seanboe/fsr_controller/scripts/images/insole.png

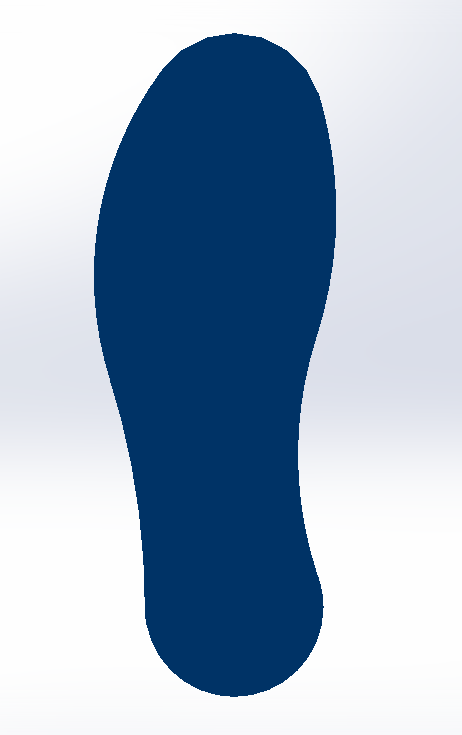
scripts/images/insole.png
