seanboe/fsr_controller/v2/footprint/QFN50P300X300X90-17N.step

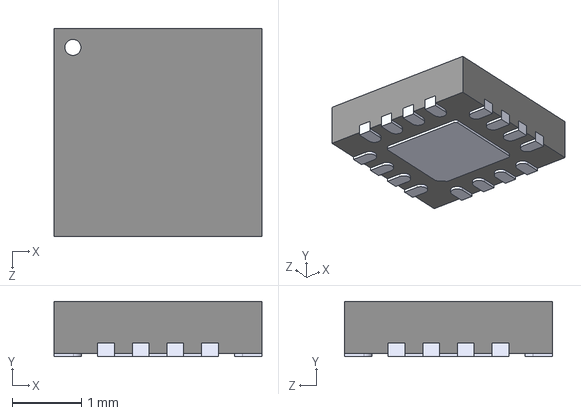
[picture p2: CAD file, 2024-06-18]
v2/footprint/QFN50P300X300X90-17N.step
3.00 x 0.8 x 3.00 mm
