seanboe/fsr_controller/v2/fsr_controller.step

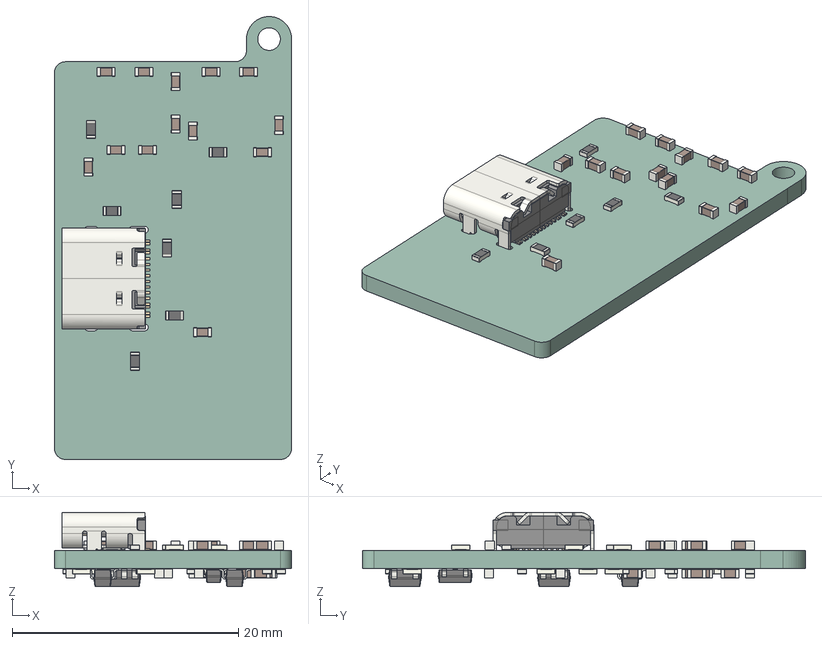
[picture p3: CAD file, 2025-02-23]
v2/fsr_controller.step
21.0 x 39.2 x 6.56 mm
C_0603_1608Metric x 26
R_0603_1608Metric x 23
USB_C_Receptacle_16P_TopMnt_Horizontal_GCT_USB4105-xx-A
SOT_23_5 x 3
SOT_23
fsr_controller2_PCB
