seanboe/fsr_controller/v2/Motor Bracket2.stl

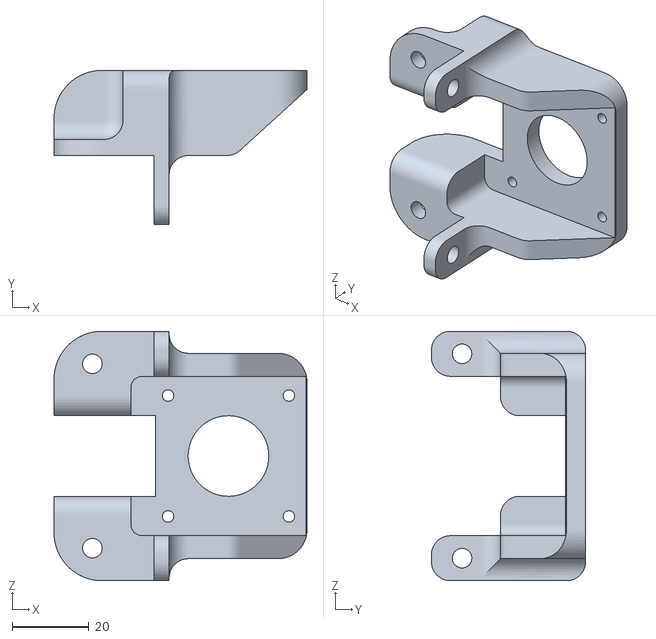
[picture p5: CAD file, 2024-06-18]
v2/Motor Bracket2.stl
65.9 x 40.2 x 65.0
