seanboe/fsr_controller/v2/footprint/ATWINC1500-MR210PB STEP model.STEP

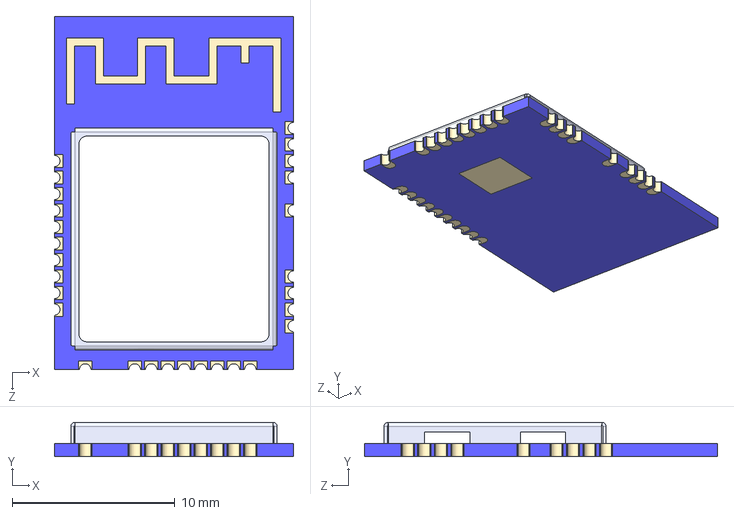
[picture p6: CAD file, 2024-06-18]
v2/footprint/ATWINC1500-MR210PB STEP model.STEP
14.7 x 2.11 x 21.7 mm
