seanboe/fsr_controller/v2/switch mount 2.stl

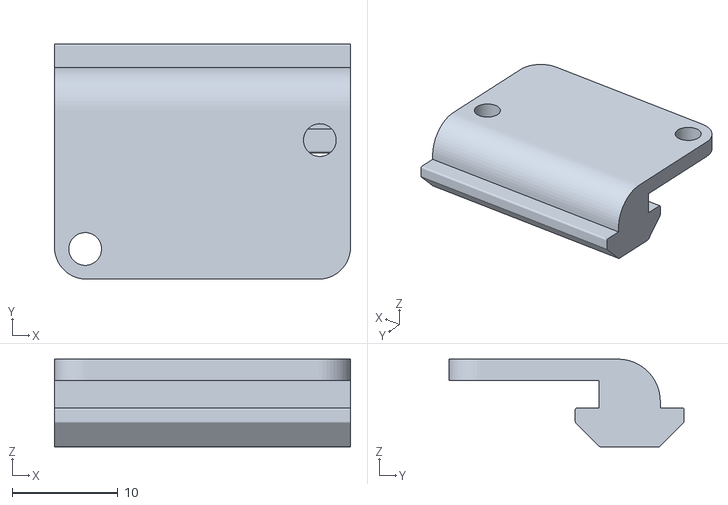
[picture p7: CAD file, 2024-06-18]
v2/switch mount 2.stl
28.0 x 22.2 x 8.30
