seanboe/fsr_controller/v2/switch mount.stl

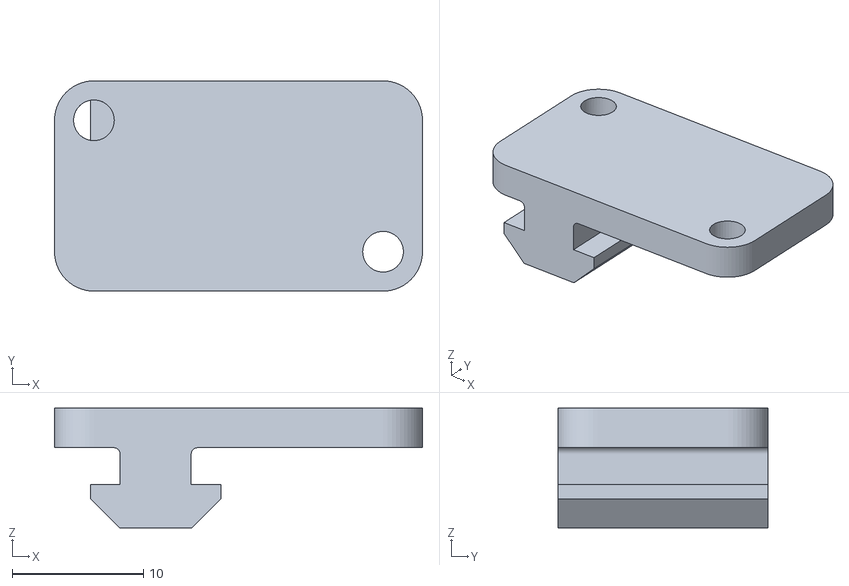
[picture p8: CAD file, 2024-06-18]
v2/switch mount.stl
28.0 x 16.0 x 9.10
