seanboe/fsr_controller/v1/fsr_controller.step

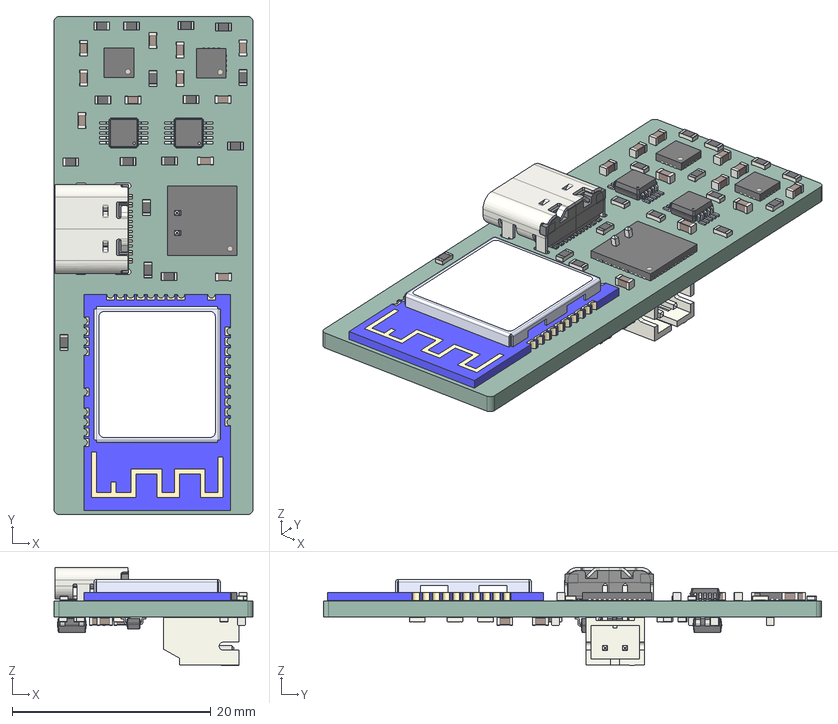
[picture p9: CAD file, 2024-06-18, an earlier design]
v1/fsr_controller.step
20.0 x 50.1 x 9.86 mm
R_0603_1608Metric x 26
C_0603_1608Metric x 19
QFN-16-1EP_3x3mm_Pitch0.5mm x 2
VSSOP_10_3x3mm_P05mm x 2
USB_C_Receptacle_16P_TopMnt_Horizontal_GCT_USB4105-xx-A
ATWINC1500-MR210PB
QFN-48-1EP_7x7mm_Pitch0.5mm
SOT_23
JST_S2B_PH_K
SOT_23_5 x 3
fsr_controller_PCB
