seanboe/fsr_controller/(list of files, cad)

Other CAD files:
v2/switch mount 2(Mirror).stl
v1/switch mount 2(Mirror).stl
