seanboe/fsr_controller/v2/fsr_controller2.kicad_pcb

## KiCad design v2/fsr_controller2.kicad_pcb (2024-06-20)

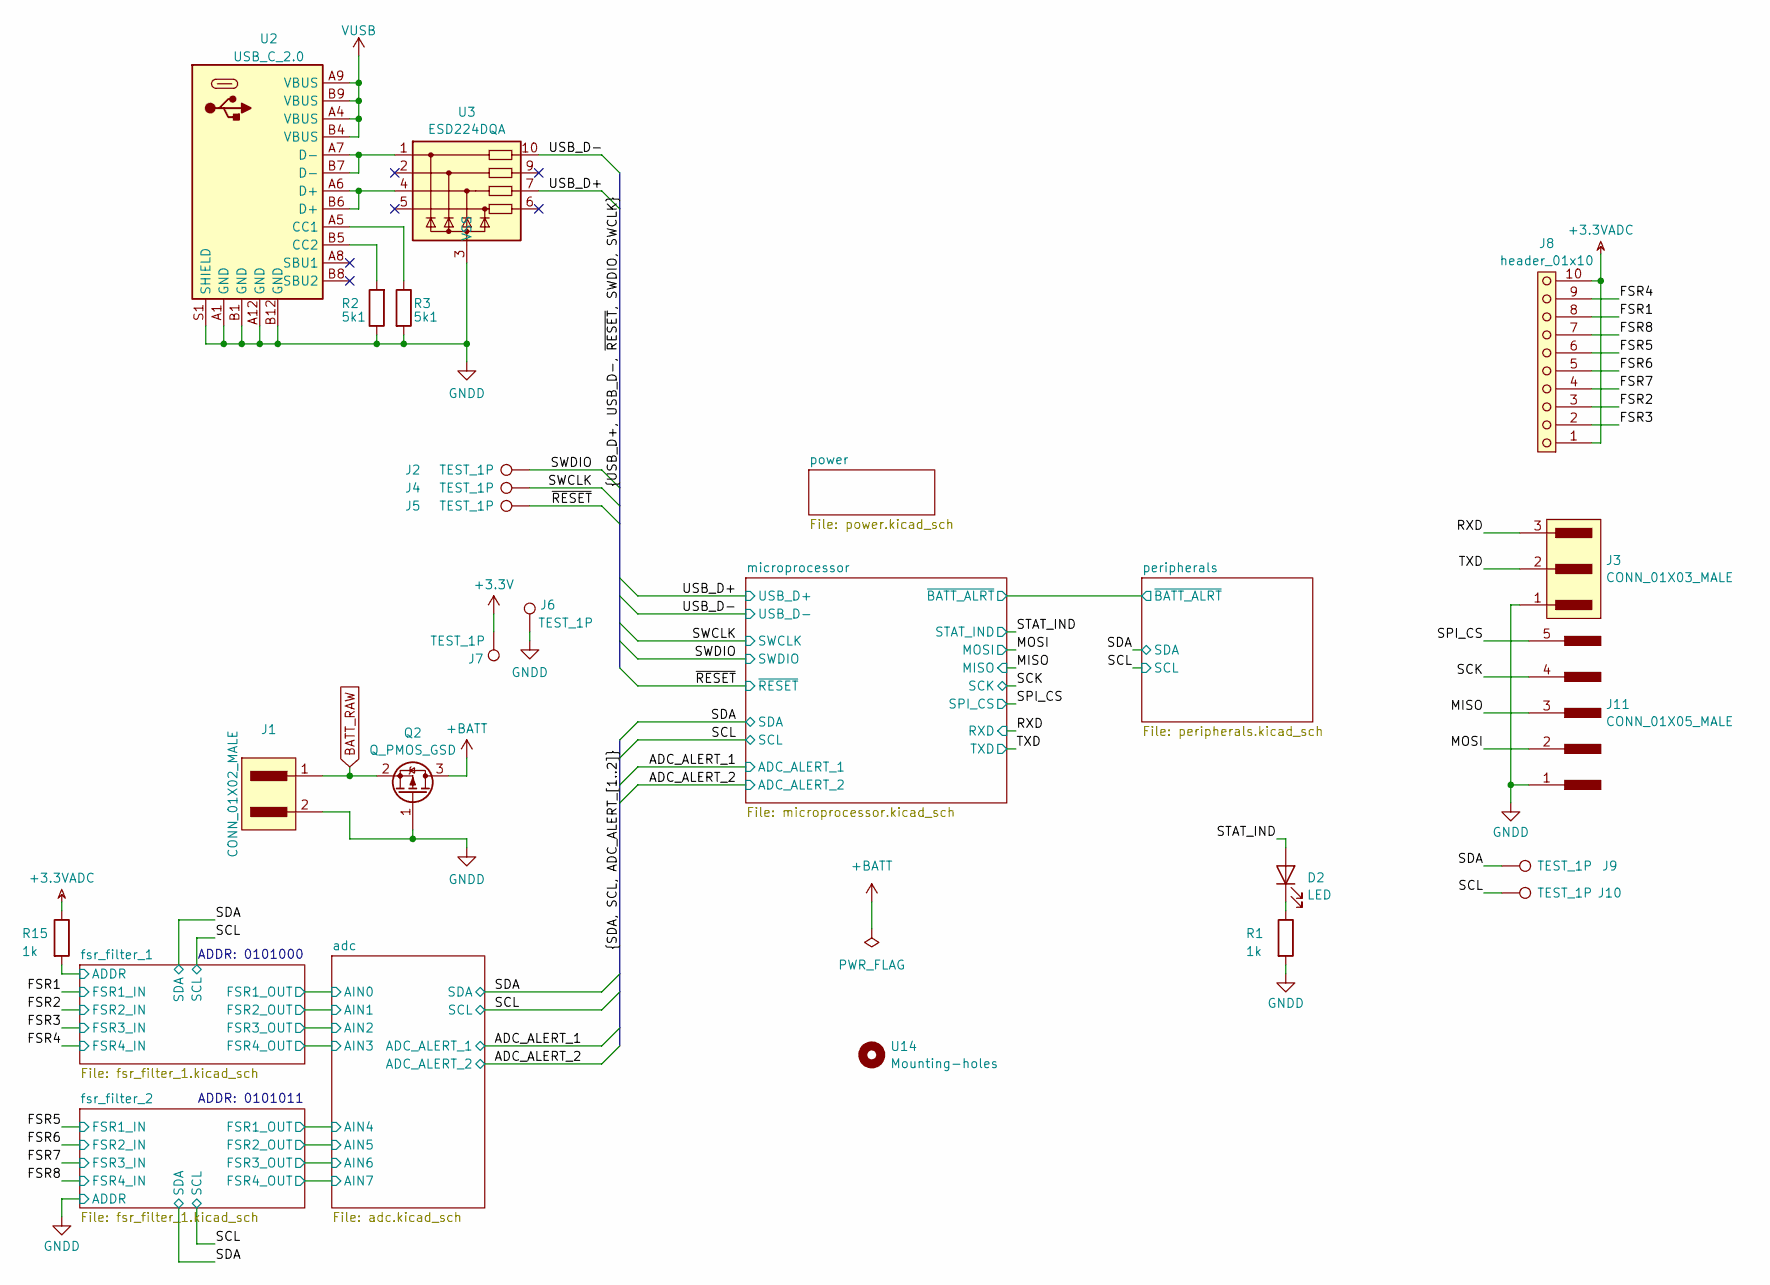
[picture p10: schematic fsr_controller2.kicad_sch]

Parts:
D2: LED; D_0603; MPN C94869
J1: CONN_01X02_MALE; JST_PH_S2B-PH-SM4-TB_1x02-1MP_P2.00mm_Horizontal; MPN C295747
J2, J4, J5, J6, J7, J9, J10: TEST_1P; test_point_1.0mm_square
J3: CONN_01X03_MALE; JST_BM03B_GHS_TB; MPN C514175
J8: header_01x10; fsr_connector
J11: CONN_01X05_MALE; JST_SM05B; MPN C189896
Q2: Q_PMOS_GSD; SOT-23; MPN C727156
R1, R15: 1k; R_1608_603_B; MPN C2984405
R2, R3: 5k1; R_1608_603_B; MPN C23186
U2: USB_C_2.0; USB_C_XKB_U262-16XN-4BVC11; MPN C165948
U3: ESD224DQA; Diodes_UDFN-10_1.0x2.5mm_P0.5mm
U14: Mounting-holes; plated_hole_2.0x2.5mm

Connections:
+3.3V: J7.1; also elsewhere on the board
+3.3VADC: J8.1, J8.10, R15.1; also elsewhere on the board
+BATT: Q2.3 (D); also elsewhere on the board
/FSR1: J8.8; also elsewhere on the board
/FSR2: J8.3; also elsewhere on the board
/FSR3: J8.2; also elsewhere on the board
/FSR4: J8.9; also elsewhere on the board
/FSR5: J8.6; also elsewhere on the board
/FSR6: J8.5; also elsewhere on the board
/FSR7: J8.4; also elsewhere on the board
/FSR8: J8.7; also elsewhere on the board
/MISO: J11.3; also elsewhere on the board
/MOSI: J11.2; also elsewhere on the board
/RXD: J3.3; also elsewhere on the board
/SCK: J11.4; also elsewhere on the board
/SCL: J10.1; also elsewhere on the board
/SDA: J9.1; also elsewhere on the board
/SPI_CS: J11.5; also elsewhere on the board
/STAT_IND: D2.2 (A); also elsewhere on the board
/SWCLK: J4.1; also elsewhere on the board
/SWDIO: J2.1; also elsewhere on the board
/TXD: J3.2; also elsewhere on the board
/USB_D+: U3.7; also elsewhere on the board
/USB_D-: U3.10; also elsewhere on the board
/fsr_filter_1/ADDR: R15.2; also elsewhere on the board
/~RESET: J5.1; also elsewhere on the board
BATT_RAW: J1.1, Q2.2 (S); also elsewhere on the board
GNDD: J1.2, J3.1, J6.1, J11.1, Q2.1 (G), R1.2, R2.1, R3.2, U2.A1 (GND), U2.A12 (GND), U2.B1 (GND), U2.B12 (GND), U2.S1 (SHIELD), U3.3 (VSS), U3.8 (VSS); also elsewhere on the board
unnamed: D2.1 (K), R1.1
unnamed: R3.1, U2.A5 (CC1)
unnamed: R2.2, U2.B5 (CC2)
unnamed: U2.A6 (D+), U2.B6 (D+), U3.4
unnamed: U2.A7 (D-), U2.B7 (D-), U3.1
VUSB: U2.A4 (VBUS), U2.A9 (VBUS), U2.B4 (VBUS), U2.B9 (VBUS); also elsewhere on the board

Notes on the sheet:
ADDR: 0101011
ADDR: 0101000

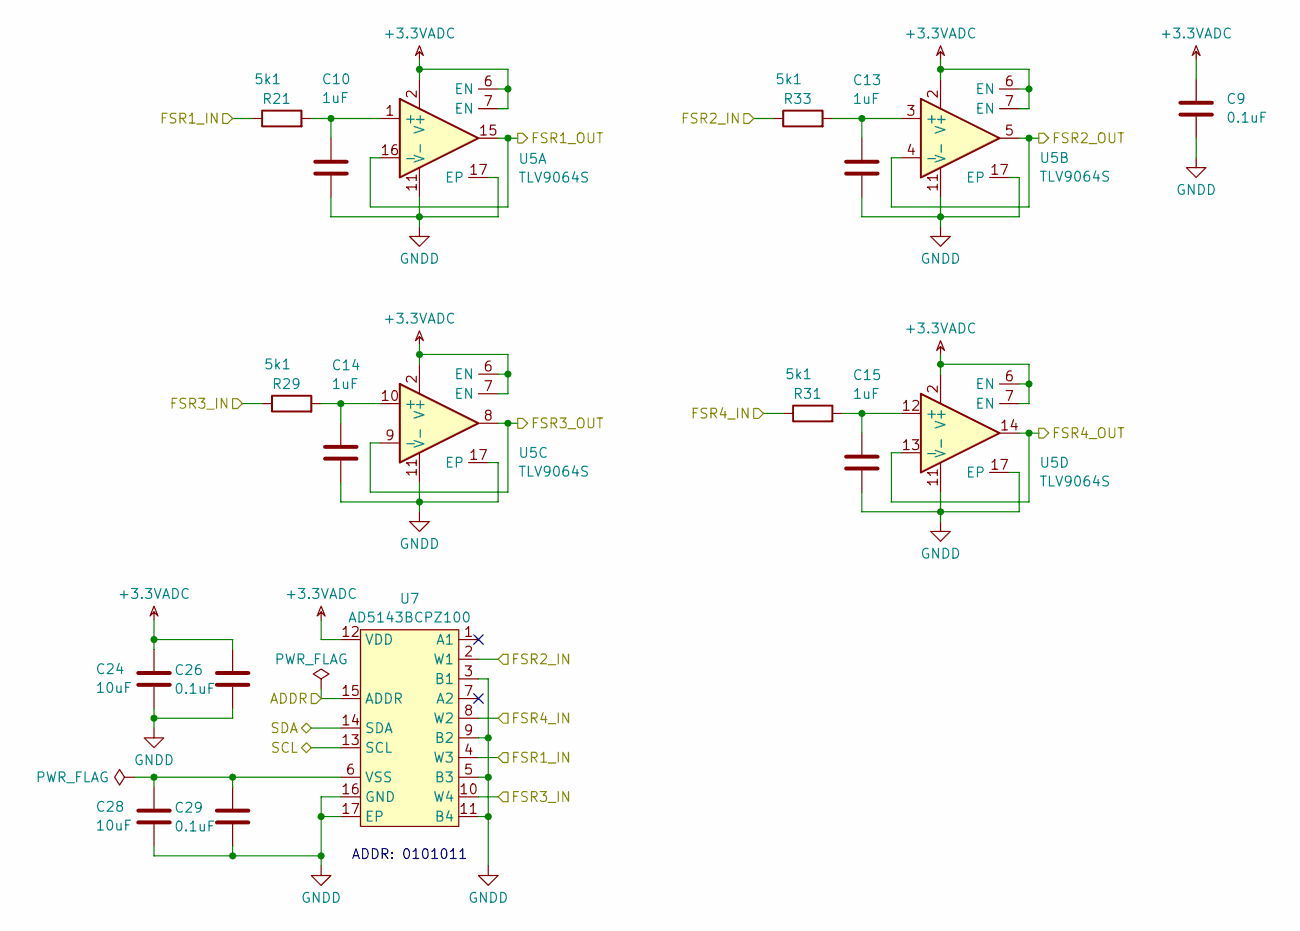
[picture p11: schematic fsr_filter_1.kicad_sch]

Parts:
C9, C26, C29: 0.1uF; C_1608_603_B; MPN C2909630
C10, C13, C14, C15: 1uF; C_1608_603_B; MPN C2918499
C24, C28: 10uF; C_1608_603_B; MPN C2909630
R21, R29, R31, R33: 5k1; R_1608_603_B; MPN C23186
U5: TLV9064S; WQFN-16-1EP_3x3mm_P0.5mm_EP1.68x1.68mm; MPN DIGI
U7: AD5143BCPZ100; WQFN-16-1EP_3x3mm_P0.5mm_EP1.68x1.68mm

Connections:
+3.3VADC: C9.1, C24.1, C26.1, U5.2 (V+), U5.6 (EN), U5.7 (EN), U7.12 (VDD); also elsewhere on the board
/FSR1: R21.1, U7.4 (W3); also elsewhere on the board
/FSR2: R33.1, U7.2 (W1); also elsewhere on the board
/FSR3: R29.1, U7.10 (W4); also elsewhere on the board
/FSR4: R31.1, U7.8 (W2); also elsewhere on the board
/SCL: U7.13 (SCL); also elsewhere on the board
/SDA: U7.14 (SDA); also elsewhere on the board
/adc/AIN0: U5.15, U5.16 (-); also elsewhere on the board
/adc/AIN1: U5.4 (-), U5.5; also elsewhere on the board
/adc/AIN2: U5.8, U5.9 (-); also elsewhere on the board
/adc/AIN3: U5.13 (-), U5.14; also elsewhere on the board
/fsr_filter_1/ADDR: U7.15 (ADDR); also elsewhere on the board
GNDD: C9.2, C10.2, C13.2, C14.2, C15.2, C24.2, C26.2, C28.2, C29.2, U5.11 (V-), U5.17 (EP), U7.3 (B1), U7.5 (B3), U7.9 (B2), U7.11 (B4), U7.16 (GND), U7.17 (EP); also elsewhere on the board
unnamed: C10.1, R21.2, U5.1 (+)
unnamed: C13.1, R33.2, U5.3 (+)
unnamed: C14.1, R29.2, U5.10 (+)
unnamed: C15.1, R31.2, U5.12 (+)
unnamed: C28.1, C29.1, U7.6 (VSS)

Parts of its further copies:
C3, C4: 10uF; C_1608_603_B; MPN C2909630
C12, C16, C25: 0.1uF; C_1608_603_B; MPN C2909630
C17, C18, C19, C22: 1uF; C_1608_603_B; MPN C2918499
R11, R12, R13, R14: 5k1; R_1608_603_B; MPN C23186
U12: TLV9064S; WQFN-16-1EP_3x3mm_P0.5mm_EP1.68x1.68mm; MPN DIGI
U13: AD5143BCPZ100; WQFN-16-1EP_3x3mm_P0.5mm_EP1.68x1.68mm

Connections of its further copies:
+3.3VADC: C3.1, C12.1, C25.1, U12.2 (V+), U12.6 (EN), U12.7 (EN), U13.12 (VDD); also elsewhere on the board
/FSR5: R11.1, U13.4 (W3); also elsewhere on the board
/FSR6: R13.1, U13.2 (W1); also elsewhere on the board
/FSR7: R12.1, U13.10 (W4); also elsewhere on the board
/FSR8: R14.1, U13.8 (W2); also elsewhere on the board
/SCL: U13.13 (SCL); also elsewhere on the board
/SDA: U13.14 (SDA); also elsewhere on the board
/adc/AIN4: U12.15, U12.16 (-); also elsewhere on the board
/adc/AIN5: U12.4 (-), U12.5; also elsewhere on the board
/adc/AIN6: U12.8, U12.9 (-); also elsewhere on the board
/adc/AIN7: U12.13 (-), U12.14; also elsewhere on the board
GNDD: C3.2, C4.2, C12.2, C16.2, C17.2, C18.2, C19.2, C22.2, C25.2, U12.11 (V-), U12.17 (EP), U13.3 (B1), U13.5 (B3), U13.9 (B2), U13.11 (B4), U13.15 (ADDR), U13.16 (GND), U13.17 (EP); also elsewhere on the board
unnamed: C17.1, R11.2, U12.1 (+)
unnamed: C19.1, R13.2, U12.3 (+)
unnamed: C18.1, R12.2, U12.10 (+)
unnamed: C22.1, R14.2, U12.12 (+)
unnamed: C4.1, C16.1, U13.6 (VSS)

Notes on the sheet:
ADDR: 0101011

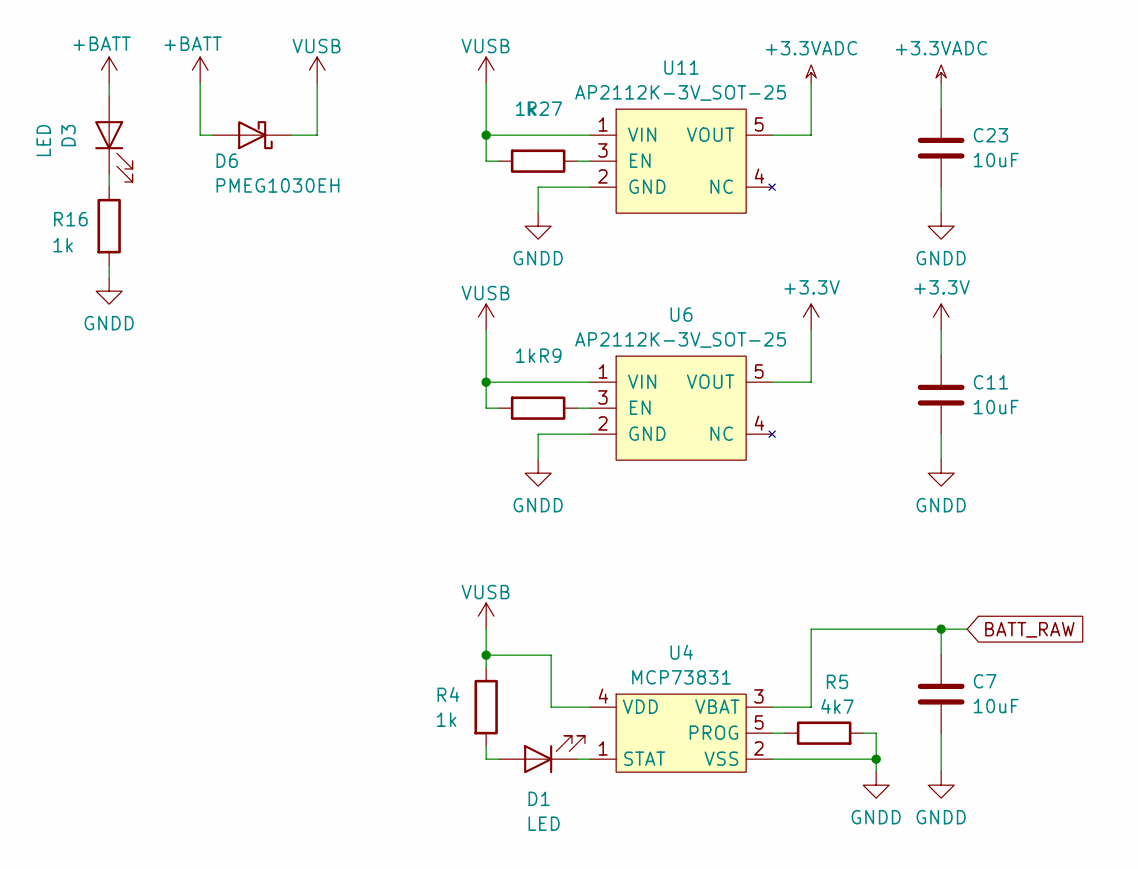
[picture p12: schematic power.kicad_sch]

Parts:
C7, C11, C23: 10uF; C_1608_603_B; MPN C2909630
D1, D3: LED; D_0603; MPN C94869
D6: PMEG1030EH; D_SOD-123F; MPN DIGI
R4, R9, R16, R27: 1k; R_1608_603_B; MPN C2984405
R5: 4k7; R_1608_603_B; MPN C2984421
U4: MCP73831; SOT-23-5; MPN C424093
U6, U11: AP2112K-3V_SOT-25; SOT-23-5; MPN C51118

Connections:
+3.3V: C11.1, U6.5 (VOUT); also elsewhere on the board
+3.3VADC: C23.1, U11.5 (VOUT); also elsewhere on the board
+BATT: D3.2 (A), D6.2 (A); also elsewhere on the board
BATT_RAW: C7.1, U4.3 (VBAT); also elsewhere on the board
GNDD: C7.2, C11.2, C23.2, R5.2, R16.2, U4.2 (VSS), U6.2 (GND), U11.2 (GND); also elsewhere on the board
unnamed: D1.2 (A), R4.2
unnamed: D1.1 (K), U4.1 (STAT)
unnamed: D3.1 (K), R16.1
unnamed: R5.1, U4.5 (PROG)
unnamed: R9.1, U6.3 (EN)
unnamed: R27.1, U11.3 (EN)
VUSB: D6.1 (K), R4.1, R9.2, R27.2, U4.4 (VDD), U6.1 (VIN), U11.1 (VIN); also elsewhere on the board

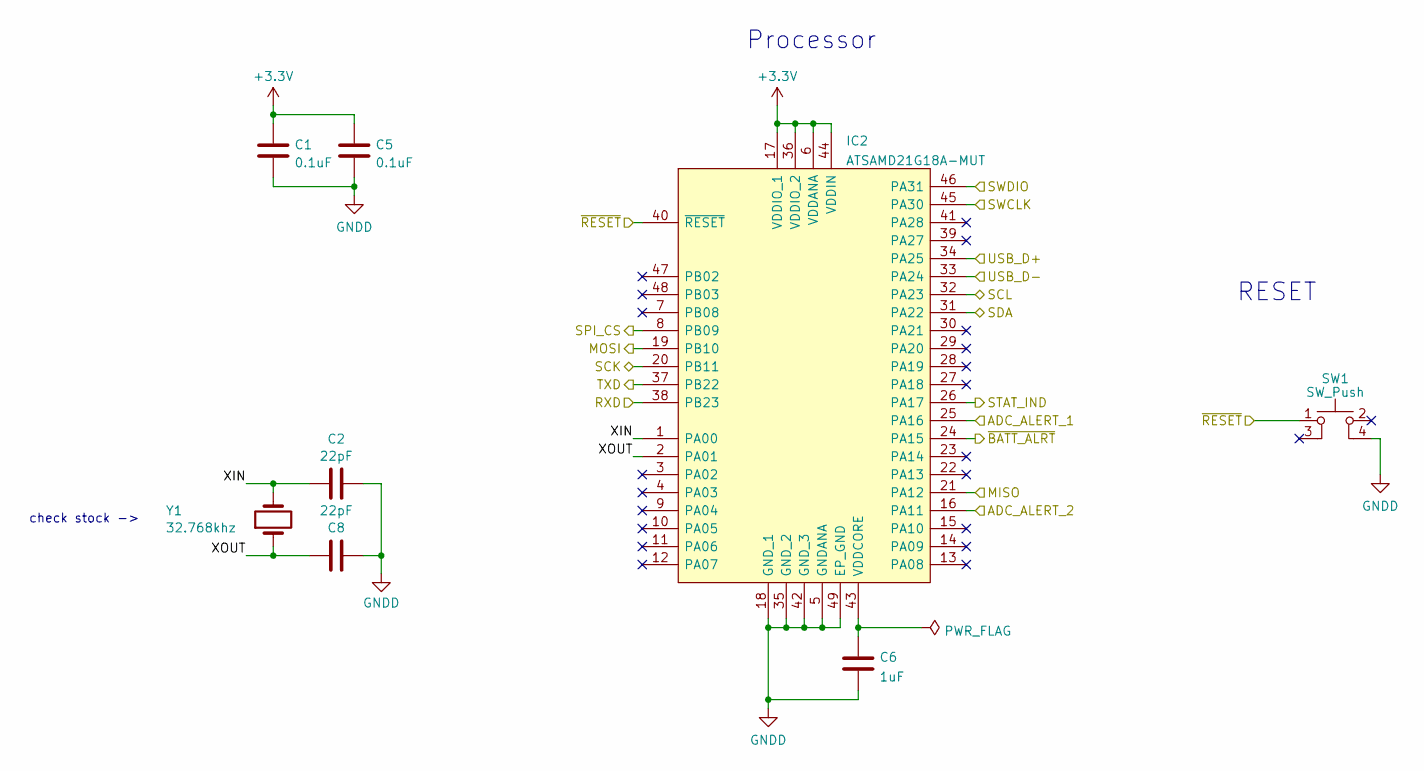
[picture p13: schematic microprocessor.kicad_sch]

Parts:
C1, C5: 0.1uF; C_1608_603_B; MPN C2909630
C2, C8: 22pF; C_1005_402_B; MPN C173271
C6: 1uF; C_1608_603_B; MPN C2918499
IC2: ATSAMD21G18A-MUT; QFN50P700X700X90-49N-D; MPN DIGI
SW1: SW_Push; TL3365AF180QG; MPN C2886926
Y1: 32.768khz; 2-smd

Connections:
+3.3V: C1.2, C5.2, IC2.6 (VDDANA), IC2.17 (VDDIO_1), IC2.36 (VDDIO_2), IC2.44 (VDDIN); also elsewhere on the board
/ADC_ALERT_1: IC2.25 (PA16); also elsewhere on the board
/ADC_ALERT_2: IC2.16 (PA11); also elsewhere on the board
/MISO: IC2.21 (PA12); also elsewhere on the board
/MOSI: IC2.19 (PB10); also elsewhere on the board
/RXD: IC2.38 (PB23); also elsewhere on the board
/SCK: IC2.20 (PB11); also elsewhere on the board
/SCL: IC2.32 (PA23); also elsewhere on the board
/SDA: IC2.31 (PA22); also elsewhere on the board
/SPI_CS: IC2.8 (PB09); also elsewhere on the board
/STAT_IND: IC2.26 (PA17); also elsewhere on the board
/SWCLK: IC2.45 (PA30); also elsewhere on the board
/SWDIO: IC2.46 (PA31); also elsewhere on the board
/TXD: IC2.37 (PB22); also elsewhere on the board
/USB_D+: IC2.34 (PA25); also elsewhere on the board
/USB_D-: IC2.33 (PA24); also elsewhere on the board
/microprocessor/XIN: C2.2, IC2.1 (PA00), Y1.2
/microprocessor/XOUT: C8.2, IC2.2 (PA01), Y1.1
/peripherals/~ALRT: IC2.24 (PA15); also elsewhere on the board
/~RESET: IC2.40 (~RESET), SW1.1; also elsewhere on the board
GNDD: C1.1, C2.1, C5.1, C6.2, C8.1, IC2.5 (GNDANA), IC2.18 (GND_1), IC2.35 (GND_2), IC2.42 (GND_3), IC2.49 (EP_GND), SW1.4; also elsewhere on the board
unnamed: C6.1, IC2.43 (VDDCORE)

Notes on the sheet:
check stock ->
RESET
Processor

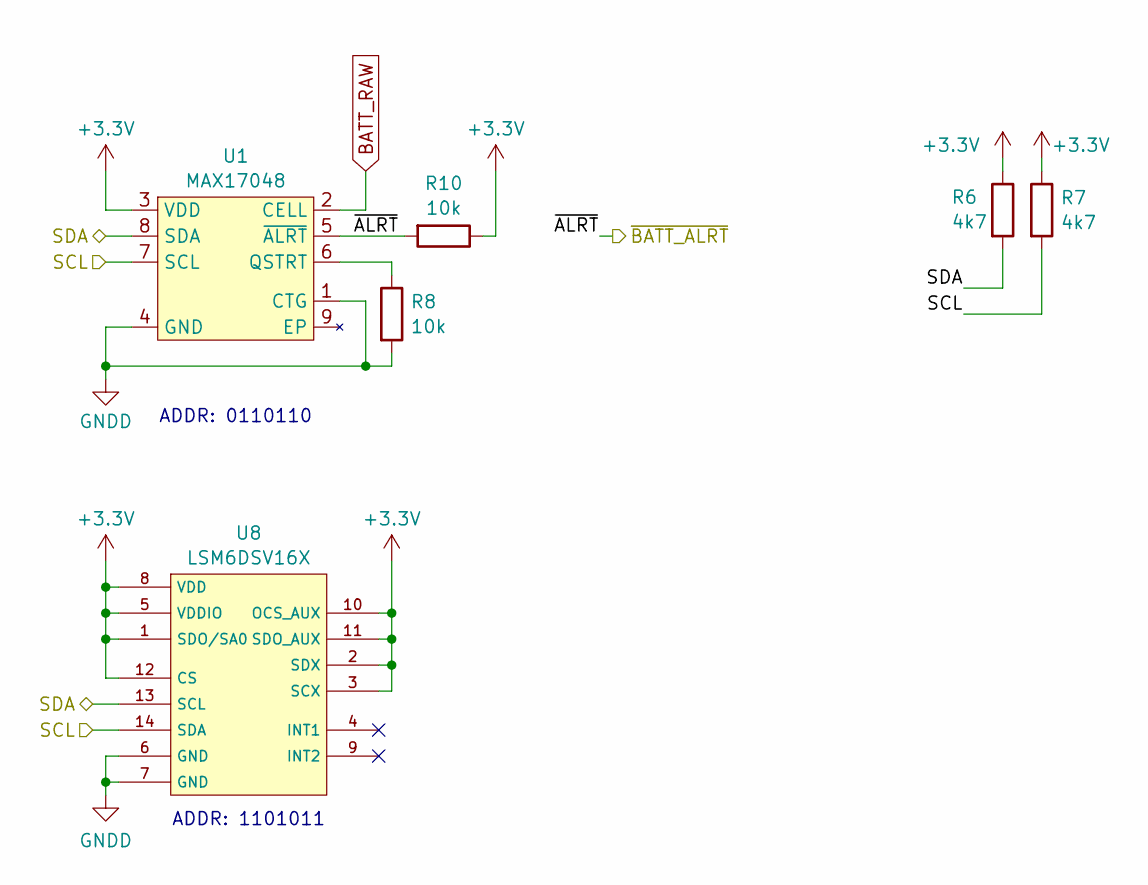
[picture p14: schematic peripherals.kicad_sch]

Parts:
R6, R7: 4k7; R_1608_603_B; MPN C2984421
R8, R10: 10k; R_1608_603_B; MPN C5123581
U1: MAX17048; DFN-8-1EP_2x2mm_P0.5mm_EP0.9x1.5mm; MPN C2682616
U8: LSM6DSV16X; PQFN50P250X300X86-14N; MPN DIGI

Connections:
+3.3V: R6.1, R7.1, R10.1, U1.3 (VDD), U8.1 (SDO/SA0), U8.2 (SDX), U8.3 (SCX), U8.5 (VDDIO), U8.8 (VDD), U8.10 (OCS_AUX), U8.11 (SDO_AUX), U8.12 (CS); also elsewhere on the board
/SCL: R7.2, U1.7 (SCL), U8.14 (SDA); also elsewhere on the board
/SDA: R6.2, U1.8 (SDA), U8.13 (SCL); also elsewhere on the board
/peripherals/~ALRT: R10.2, U1.5 (~ALRT); also elsewhere on the board
BATT_RAW: U1.2 (CELL); also elsewhere on the board
GNDD: R8.2, U1.1 (CTG), U1.4 (GND), U8.6 (GND), U8.7 (GND); also elsewhere on the board
unnamed: R8.1, U1.6 (QSTRT)

Notes on the sheet:
ADDR: 1101011
ADDR: 0110110

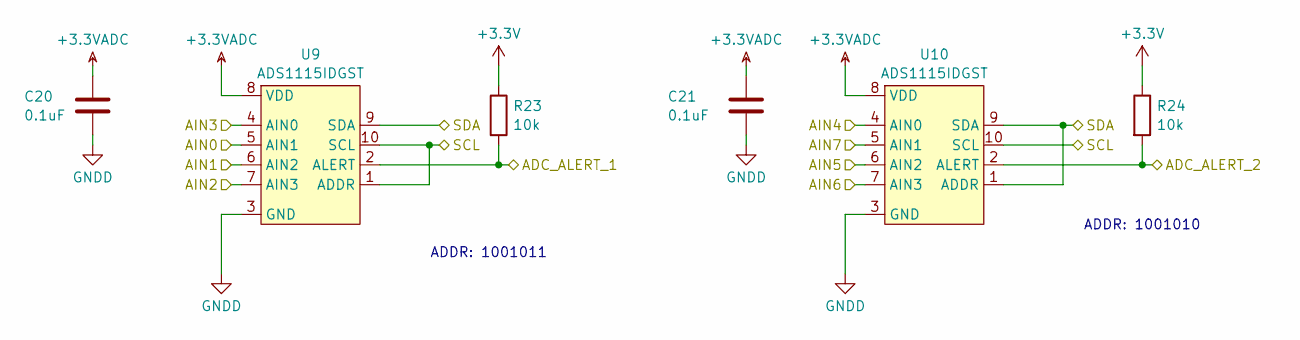
[picture p15: schematic adc.kicad_sch]

Parts:
C20, C21: 0.1uF; C_1608_603_B; MPN C2909630
R23, R24: 10k; R_1608_603_B; MPN C5123581
U9, U10: ADS1115IDGST; VSSOP-10_3x3mm_P0.5mm

Connections:
+3.3V: R23.1, R24.1; also elsewhere on the board
+3.3VADC: C20.1, C21.1, U9.8 (VDD), U10.8 (VDD); also elsewhere on the board
/ADC_ALERT_1: R23.2, U9.2 (ALERT); also elsewhere on the board
/ADC_ALERT_2: R24.2, U10.2 (ALERT); also elsewhere on the board
/SCL: U9.1 (ADDR), U9.10 (SCL), U10.10 (SCL); also elsewhere on the board
/SDA: U9.9 (SDA), U10.1 (ADDR), U10.9 (SDA); also elsewhere on the board
/adc/AIN0: U9.5 (AIN1); also elsewhere on the board
/adc/AIN1: U9.6 (AIN2); also elsewhere on the board
/adc/AIN2: U9.7 (AIN3); also elsewhere on the board
/adc/AIN3: U9.4 (AIN0); also elsewhere on the board
/adc/AIN4: U10.4 (AIN0); also elsewhere on the board
/adc/AIN5: U10.6 (AIN2); also elsewhere on the board
/adc/AIN6: U10.7 (AIN3); also elsewhere on the board
/adc/AIN7: U10.5 (AIN1); also elsewhere on the board
GNDD: C20.2, C21.2, U9.3 (GND), U10.3 (GND); also elsewhere on the board

Notes on the sheet:
ADDR: 1001010
ADDR: 1001011

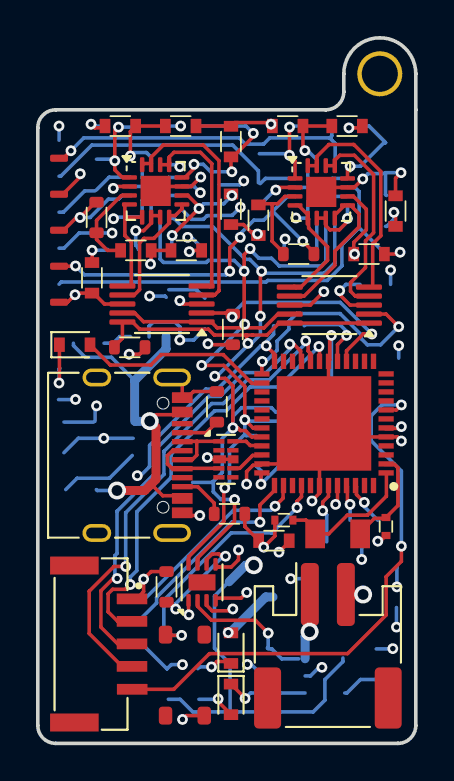
[picture p16: board fsr_controller2.kicad_pcb from above]

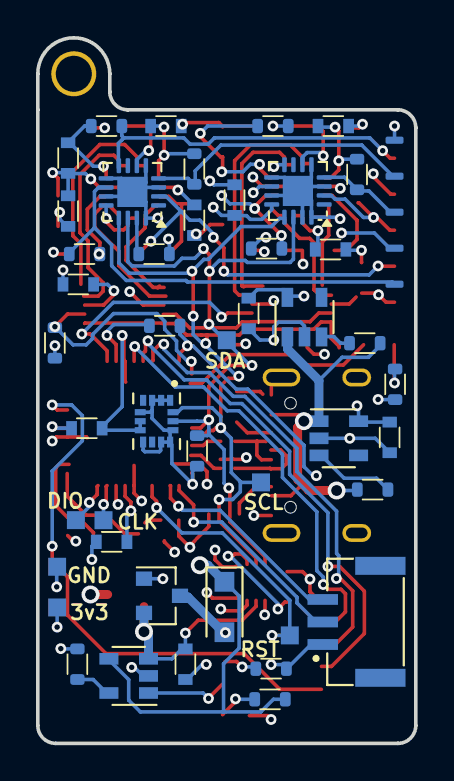
[picture p17: board fsr_controller2.kicad_pcb from below]

Board: 4 copper layers, 21.0 x 39.2 mm, 84 parts (45 on the bottom side), 65 nets.
