seanboe/fsr_controller/v1/fsr_controller.kicad_pcb

## KiCad design v1/fsr_controller.kicad_pcb (2024-06-18, an earlier design)

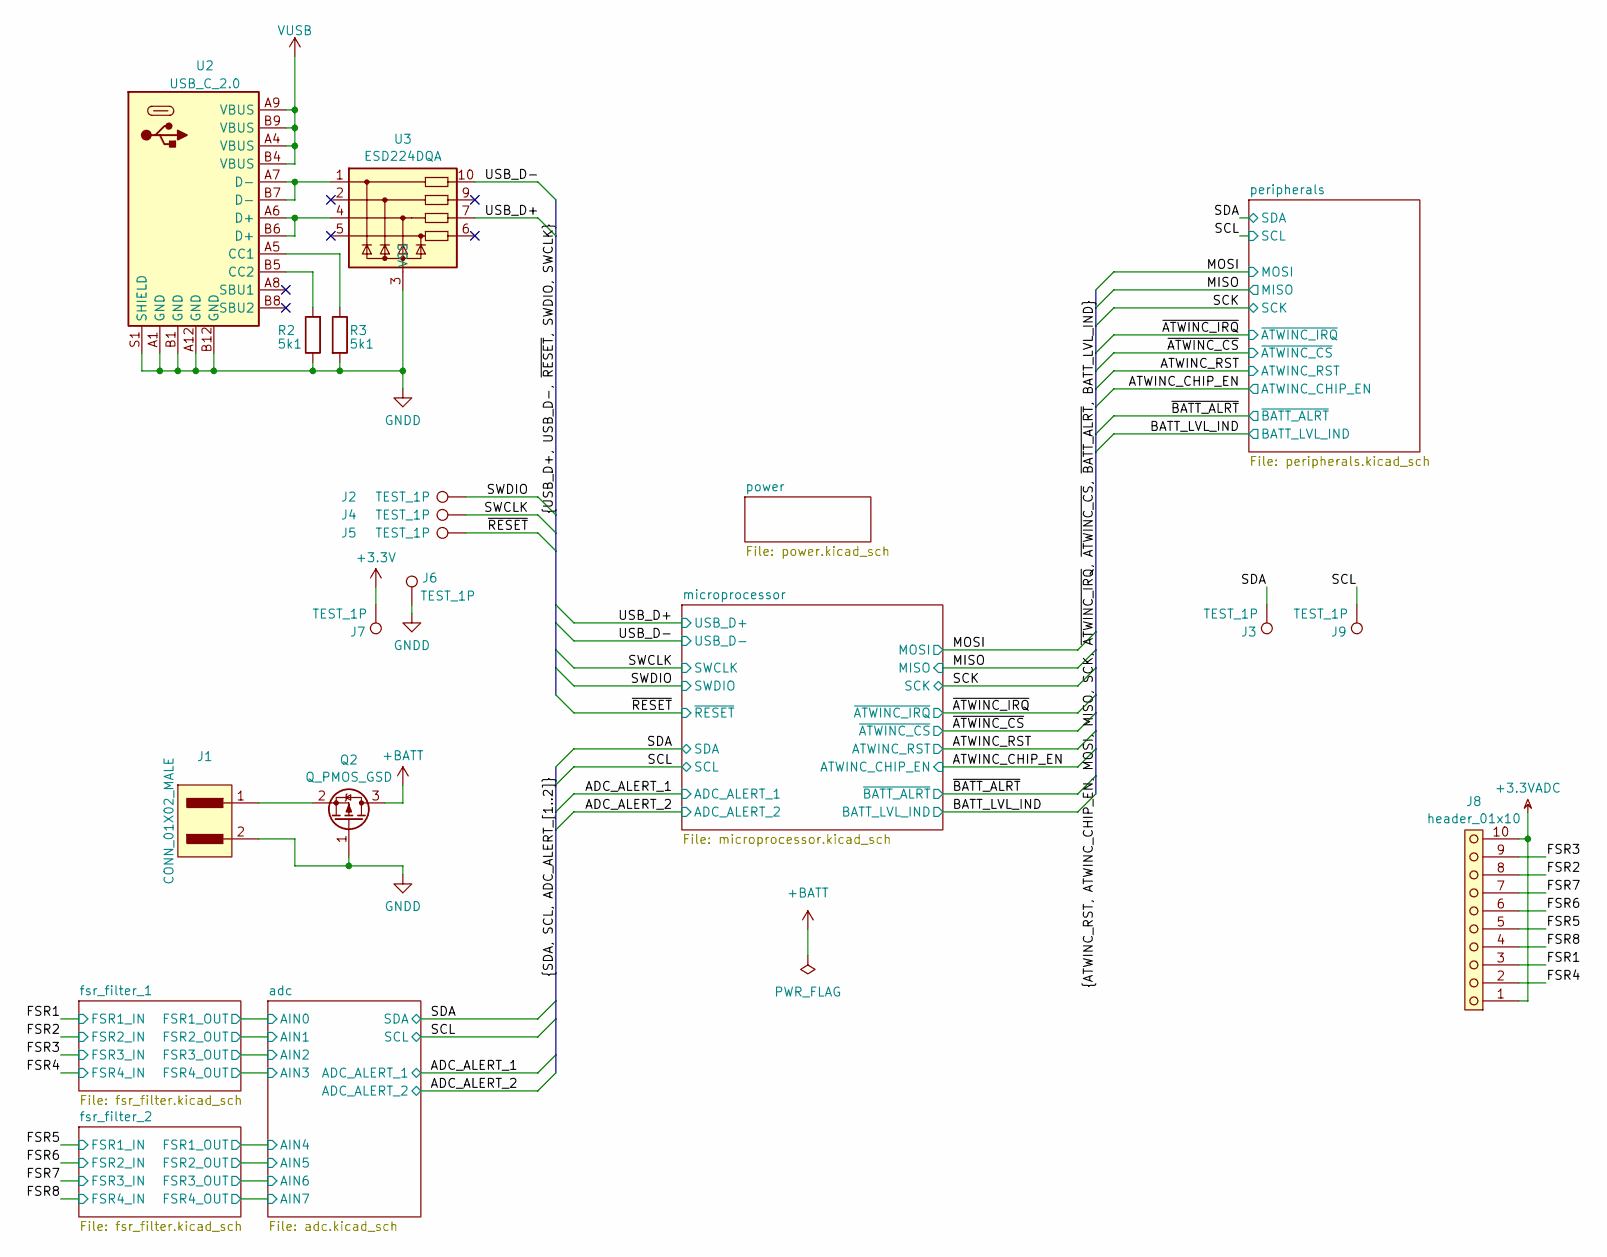
[picture p18: schematic fsr_controller.kicad_sch]

Parts:
J1: CONN_01X02_MALE; JST_PH_S2B-PH-SM4-TB_1x02-1MP_P2.00mm_Horizontal
J2, J3, J4, J5, J6, J7, J9: TEST_1P; test_point_1.0mm_square
J8: header_01x10; fsr_connector
Q2: Q_PMOS_GSD; SOT-23
R2, R3: 5k1; R_1608_603_B
U2: USB_C_2.0; USB_C_XKB_U262-16XN-4BVC11
U3: ESD224DQA; Diodes_UDFN-10_1.0x2.5mm_P0.5mm

Connections:
+3.3V: J7.1; also elsewhere on the board
+3.3VADC: J8.1, J8.10; also elsewhere on the board
+BATT: Q2.3 (D); also elsewhere on the board
/FSR1: J8.3; also elsewhere on the board
/FSR2: J8.8; also elsewhere on the board
/FSR3: J8.9; also elsewhere on the board
/FSR4: J8.2; also elsewhere on the board
/FSR5: J8.5; also elsewhere on the board
/FSR6: J8.6; also elsewhere on the board
/FSR7: J8.7; also elsewhere on the board
/FSR8: J8.4; also elsewhere on the board
/SCL: J9.1; also elsewhere on the board
/SDA: J3.1; also elsewhere on the board
/SWCLK: J4.1; also elsewhere on the board
/SWDIO: J2.1; also elsewhere on the board
/USB_D+: U3.7; also elsewhere on the board
/USB_D-: U3.10; also elsewhere on the board
/~RESET: J5.1; also elsewhere on the board
GNDD: J1.2, J6.1, Q2.1 (G), R2.1, R3.2, U2.A1 (GND), U2.A12 (GND), U2.B1 (GND), U2.B12 (GND), U2.S1 (SHIELD), U3.3 (VSS), U3.8 (VSS); also elsewhere on the board
unnamed: J1.1, Q2.2 (S)
unnamed: R3.1, U2.A5 (CC1)
unnamed: R2.2, U2.B5 (CC2)
unnamed: U2.A6 (D+), U2.B6 (D+), U3.4
unnamed: U2.A7 (D-), U2.B7 (D-), U3.1
VUSB: U2.A4 (VBUS), U2.A9 (VBUS), U2.B4 (VBUS), U2.B9 (VBUS); also elsewhere on the board

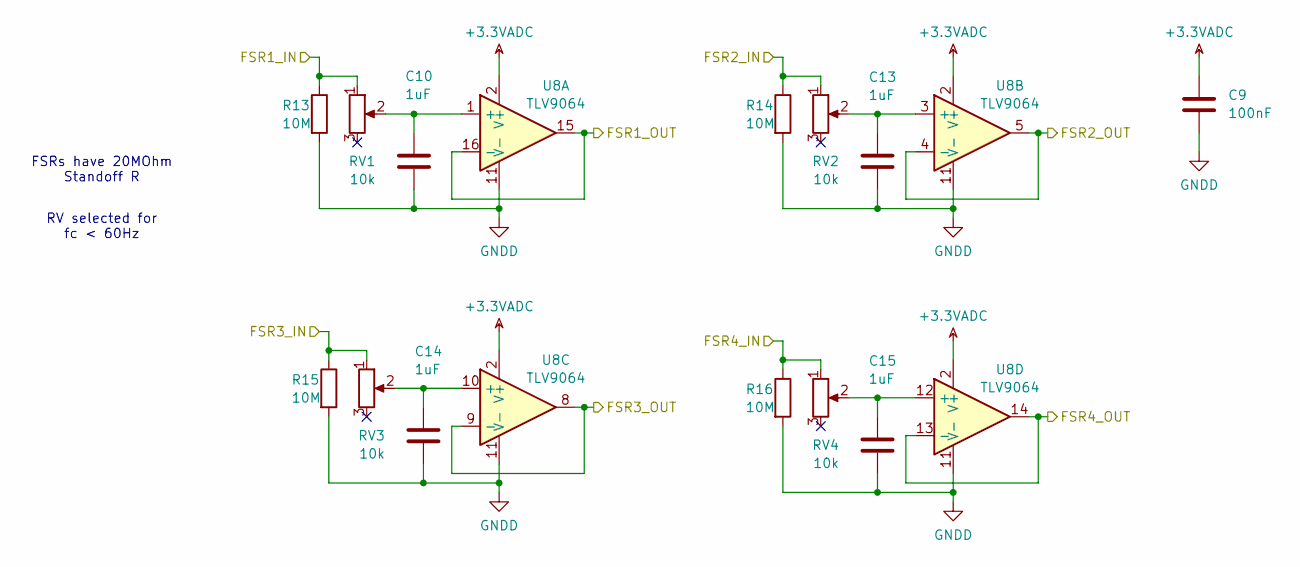
[picture p19: schematic fsr_filter.kicad_sch]

Parts:
C9: 100nF; C_1608_603_B
C10, C13, C14, C15: 1uF; C_1608_603_B
R13, R14, R15, R16: 10M; R_1608_603_B
RV1, RV2, RV3, RV4: 10k; potentiometer
U8: TLV9064; WQFN-16-1EP_3x3mm_P0.5mm_EP1.68x1.68mm

Connections:
+3.3VADC: C9.1, U8.2 (V+); also elsewhere on the board
/FSR1: R13.1, RV1.1; also elsewhere on the board
/FSR2: R14.1, RV2.1; also elsewhere on the board
/FSR3: R15.1, RV3.1; also elsewhere on the board
/FSR4: R16.1, RV4.1; also elsewhere on the board
/adc/AIN4: U8.15, U8.16 (-); also elsewhere on the board
/adc/AIN5: U8.4 (-), U8.5; also elsewhere on the board
/adc/AIN6: U8.8, U8.9 (-); also elsewhere on the board
/adc/AIN7: U8.13 (-), U8.14; also elsewhere on the board
GNDD: C9.2, C10.2, C13.2, C14.2, C15.2, R13.2, R14.2, R15.2, R16.2, U8.11 (V-); also elsewhere on the board

Parts of its further copies:
C16, C17, C18, C19: 1uF; C_1608_603_B
C22: 100nF; C_1608_603_B
R17, R18, R19, R20: 10M; R_1608_603_B
RV5, RV6, RV7, RV8: 10k; potentiometer
U7: TLV9064; WQFN-16-1EP_3x3mm_P0.5mm_EP1.68x1.68mm

Connections of its further copies:
+3.3VADC: C22.1, U7.2 (V+); also elsewhere on the board
/FSR5: R17.1, RV5.1; also elsewhere on the board
/FSR6: R19.1, RV7.1; also elsewhere on the board
/FSR7: R18.1, RV6.1; also elsewhere on the board
/FSR8: R20.1, RV8.1; also elsewhere on the board
/adc/AIN0: U7.15, U7.16 (-); also elsewhere on the board
/adc/AIN1: U7.4 (-), U7.5; also elsewhere on the board
/adc/AIN2: U7.8, U7.9 (-); also elsewhere on the board
/adc/AIN3: U7.13 (-), U7.14; also elsewhere on the board
GNDD: C16.2, C17.2, C18.2, C19.2, C22.2, R17.2, R18.2, R19.2, R20.2, U7.11 (V-); also elsewhere on the board

Notes on the sheet:
FSRs have 20MOhm Standoff R
RV selected for fc < 60Hz

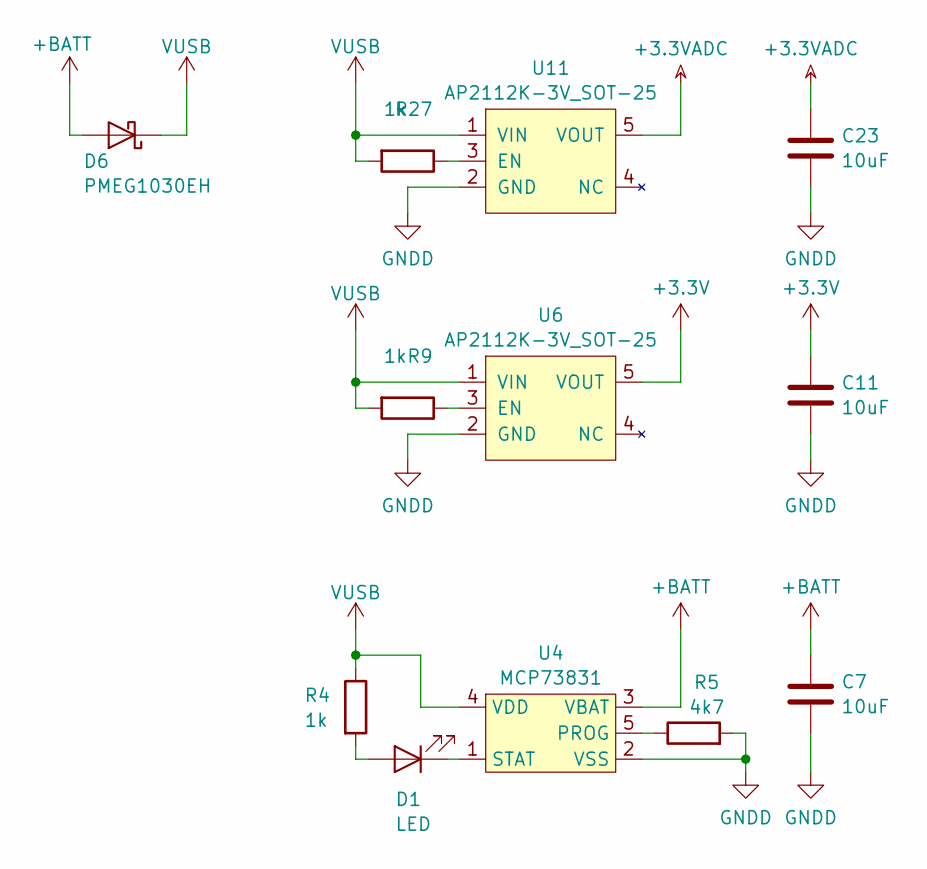
[picture p20: schematic power.kicad_sch]

Parts:
C7, C11, C23: 10uF; C_1608_603_B
D1: LED; D_0603
D6: PMEG1030EH; D_SOD-123F
R4, R9, R27: 1k; R_1608_603_B
R5: 4k7; R_1608_603_B
U4: MCP73831; SOT-23-5
U6, U11: AP2112K-3V_SOT-25; SOT-23-5

Connections:
+3.3V: C11.1, U6.5 (VOUT); also elsewhere on the board
+3.3VADC: C23.1, U11.5 (VOUT); also elsewhere on the board
+BATT: C7.1, D6.2 (A), U4.3 (VBAT); also elsewhere on the board
GNDD: C7.2, C11.2, C23.2, R5.2, U4.2 (VSS), U6.2 (GND), U11.2 (GND); also elsewhere on the board
unnamed: D1.2 (A), R4.2
unnamed: D1.1 (K), U4.1 (STAT)
unnamed: R5.1, U4.5 (PROG)
unnamed: R9.1, U6.3 (EN)
unnamed: R27.1, U11.3 (EN)
VUSB: D6.1 (K), R4.1, R9.2, R27.2, U4.4 (VDD), U6.1 (VIN), U11.1 (VIN); also elsewhere on the board

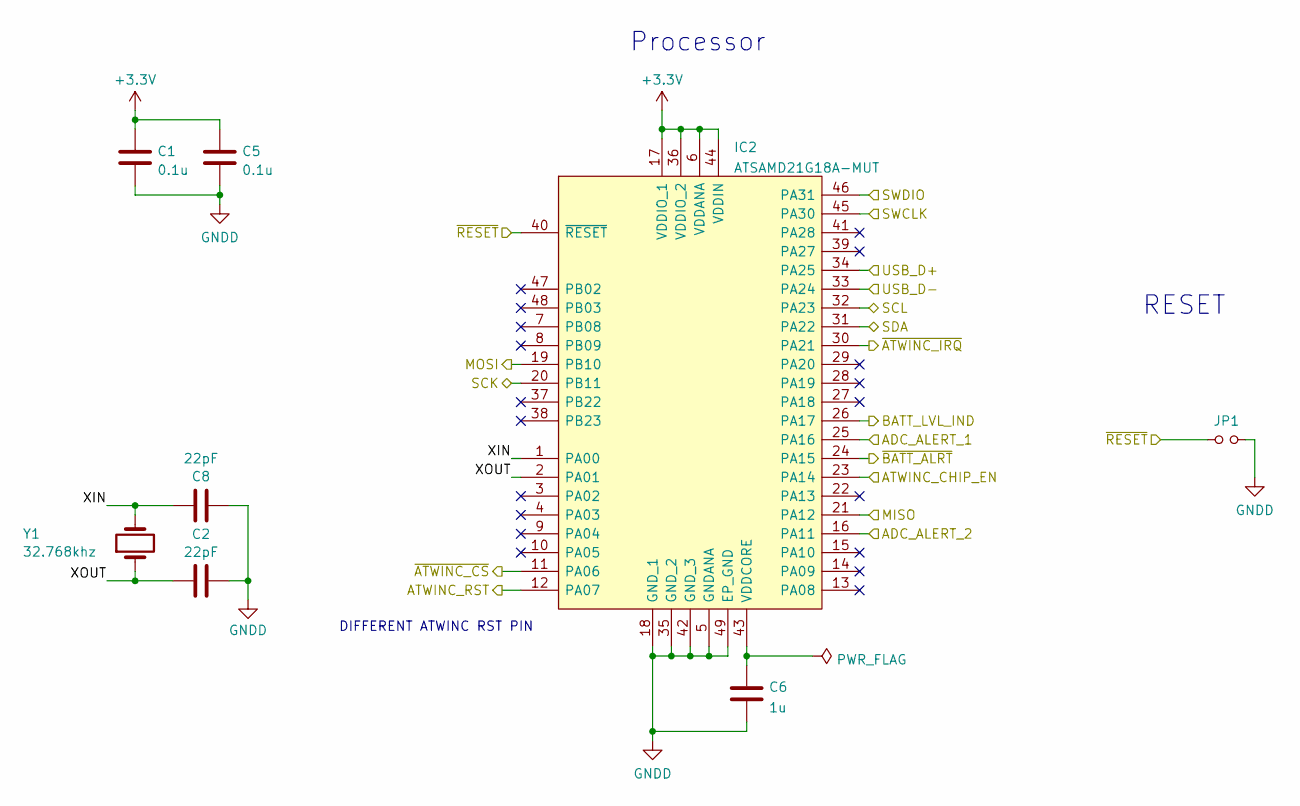
[picture p21: schematic microprocessor.kicad_sch]

Parts:
C1, C5: 0.1u; C_1608_603_B
C2, C8: 22pF; C_1005_402_B
C6: 1u; C_1608_603_B
IC2: ATSAMD21G18A-MUT; QFN50P700X700X90-49N-D
JP1: Jumper_NO_Small; SolderJumper-2_P1.3mm_Open_RoundedPad1.0x1.5mm
Y1: 32.768khz; 2-smd

Connections:
+3.3V: C1.2, C5.2, IC2.6 (VDDANA), IC2.17 (VDDIO_1), IC2.36 (VDDIO_2), IC2.44 (VDDIN); also elsewhere on the board
/ADC_ALERT_1: IC2.25 (PA16); also elsewhere on the board
/ADC_ALERT_2: IC2.16 (PA11); also elsewhere on the board
/ATWINC_CHIP_EN: IC2.23 (PA14); also elsewhere on the board
/ATWINC_RST: IC2.12 (PA07); also elsewhere on the board
/BATT_LVL_IND: IC2.26 (PA17); also elsewhere on the board
/MISO: IC2.21 (PA12); also elsewhere on the board
/MOSI: IC2.19 (PB10); also elsewhere on the board
/SCK: IC2.20 (PB11); also elsewhere on the board
/SCL: IC2.32 (PA23); also elsewhere on the board
/SDA: IC2.31 (PA22); also elsewhere on the board
/SWCLK: IC2.45 (PA30); also elsewhere on the board
/SWDIO: IC2.46 (PA31); also elsewhere on the board
/USB_D+: IC2.34 (PA25); also elsewhere on the board
/USB_D-: IC2.33 (PA24); also elsewhere on the board
/microprocessor/XIN: C8.2, IC2.1 (PA00), Y1.2
/microprocessor/XOUT: C2.2, IC2.2 (PA01), Y1.1
/~ATWINC_CS: IC2.11 (PA06); also elsewhere on the board
/~ATWINC_IRQ: IC2.30 (PA21); also elsewhere on the board
/~BATT_ALRT: IC2.24 (PA15); also elsewhere on the board
/~RESET: IC2.40 (~RESET), JP1.1; also elsewhere on the board
GNDD: C1.1, C2.1, C5.1, C6.2, C8.1, IC2.5 (GNDANA), IC2.18 (GND_1), IC2.35 (GND_2), IC2.42 (GND_3), IC2.49 (EP_GND), JP1.2; also elsewhere on the board
unnamed: C6.1, IC2.43 (VDDCORE)

Notes on the sheet:
RESET
DIFFERENT ATWINC RST PIN
Processor
