seanboe/fsr_controller/v1/fsr_controller.kicad_pcb

## KiCad design v1/fsr_controller.kicad_pcb (continued)

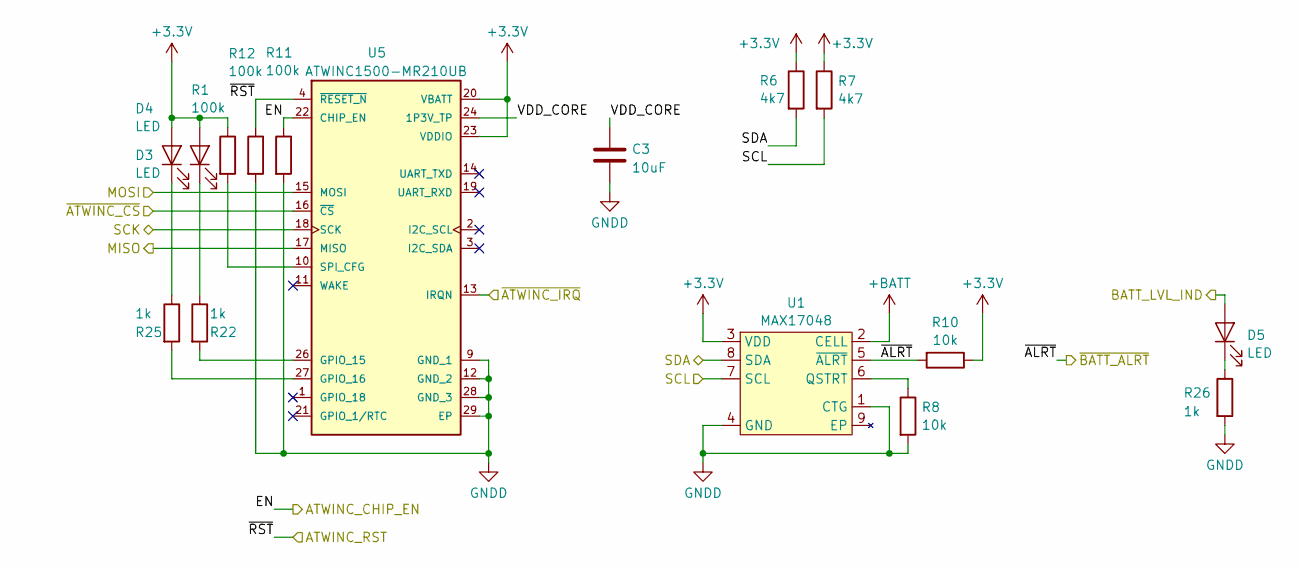
[picture p22: schematic peripherals.kicad_sch]

Parts:
C3: 10uF; C_1608_603_B
D3, D4, D5: LED; D_0603
R1, R11, R12: 100k; R_1608_603_B
R6, R7: 4k7; R_1608_603_B
R8, R10: 10k; R_1608_603_B
R22, R25, R26: 1k; R_1608_603_B
U1: MAX17048; DFN-8-1EP_2x2mm_P0.5mm_EP0.9x1.5mm
U5: ATWINC1500-MR210UB; MICROCHIP_ATWINC1500-MR210UB

Connections:
+3.3V: D3.2 (A), D4.2 (A), R1.1, R6.1, R7.1, R10.1, U1.3 (VDD), U5.20 (VBATT), U5.23 (VDDIO); also elsewhere on the board
+BATT: U1.2 (CELL); also elsewhere on the board
/ATWINC_CHIP_EN: R11.1, U5.22 (CHIP_EN); also elsewhere on the board
/ATWINC_RST: R12.1, U5.4 (~RESET_N); also elsewhere on the board
/BATT_LVL_IND: D5.2 (A); also elsewhere on the board
/MISO: U5.17 (MISO); also elsewhere on the board
/MOSI: U5.15 (MOSI); also elsewhere on the board
/SCK: U5.18 (SCK); also elsewhere on the board
/SCL: R7.2, U1.7 (SCL); also elsewhere on the board
/SDA: R6.2, U1.8 (SDA); also elsewhere on the board
/peripherals/VDD_CORE: C3.2, U5.24 (1P3V_TP)
/~ATWINC_CS: U5.16 (~CS); also elsewhere on the board
/~ATWINC_IRQ: U5.13 (IRQN); also elsewhere on the board
/~BATT_ALRT: R10.2, U1.5 (~ALRT); also elsewhere on the board
GNDD: C3.1, R8.2, R11.2, R12.2, R26.2, U1.1 (CTG), U1.4 (GND), U5.9 (GND_1), U5.12 (GND_2), U5.28 (GND_3), U5.29 (EP); also elsewhere on the board
unnamed: D3.1 (K), R22.1
unnamed: D4.1 (K), R25.1
unnamed: D5.1 (K), R26.1
unnamed: R8.1, U1.6 (QSTRT)
unnamed: R22.2, U5.26 (GPIO_15)
unnamed: R25.2, U5.27 (GPIO_16)
unnamed: R1.2, U5.10 (SPI_CFG)

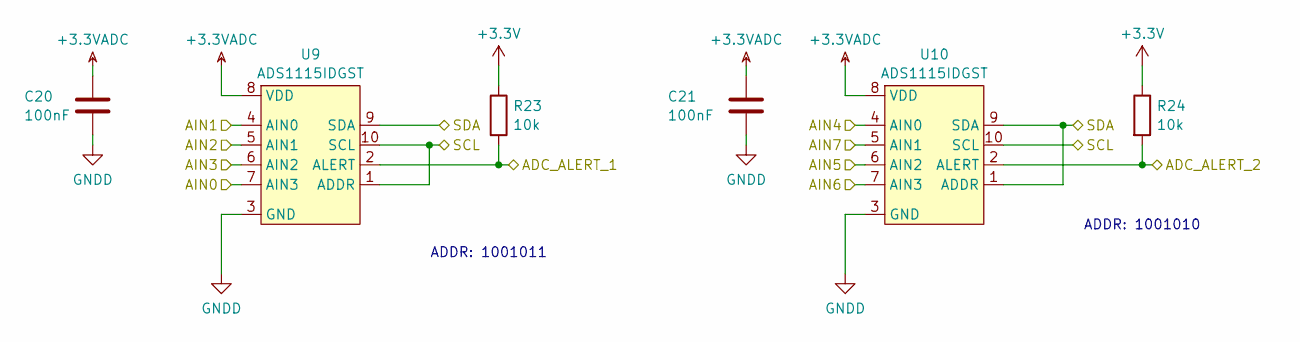
[picture p23: schematic adc.kicad_sch]

Parts:
C20, C21: 100nF; C_1608_603_B
R23, R24: 10k; R_1608_603_B
U9, U10: ADS1115IDGST; VSSOP-10_3x3mm_P0.5mm

Connections:
+3.3V: R23.1, R24.1; also elsewhere on the board
+3.3VADC: C20.1, C21.1, U9.8 (VDD), U10.8 (VDD); also elsewhere on the board
/ADC_ALERT_1: R23.2, U9.2 (ALERT); also elsewhere on the board
/ADC_ALERT_2: R24.2, U10.2 (ALERT); also elsewhere on the board
/SCL: U9.1 (ADDR), U9.10 (SCL), U10.10 (SCL); also elsewhere on the board
/SDA: U9.9 (SDA), U10.1 (ADDR), U10.9 (SDA); also elsewhere on the board
/adc/AIN0: U9.7 (AIN3); also elsewhere on the board
/adc/AIN1: U9.4 (AIN0); also elsewhere on the board
/adc/AIN2: U9.5 (AIN1); also elsewhere on the board
/adc/AIN3: U9.6 (AIN2); also elsewhere on the board
/adc/AIN4: U10.4 (AIN0); also elsewhere on the board
/adc/AIN5: U10.6 (AIN2); also elsewhere on the board
/adc/AIN6: U10.7 (AIN3); also elsewhere on the board
/adc/AIN7: U10.5 (AIN1); also elsewhere on the board
GNDD: C20.2, C21.2, U9.3 (GND), U10.3 (GND); also elsewhere on the board

Notes on the sheet:
ADDR: 1001010
ADDR: 1001011

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
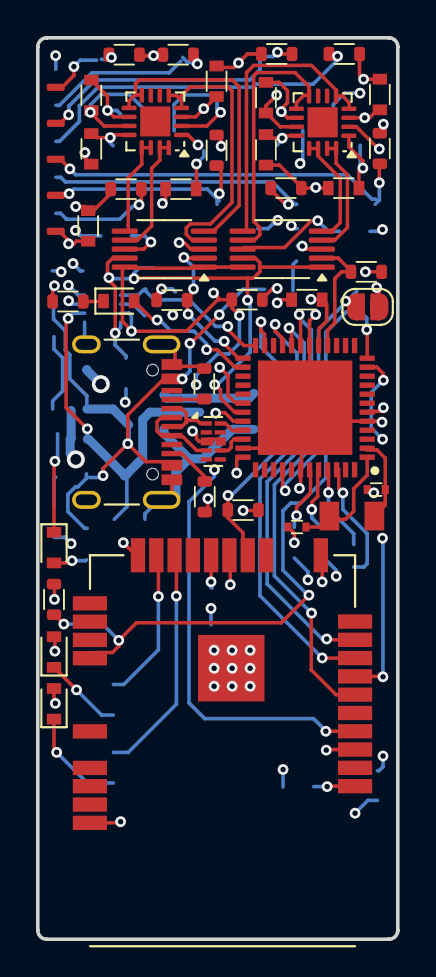
[picture p24: board fsr_controller.kicad_pcb from above]

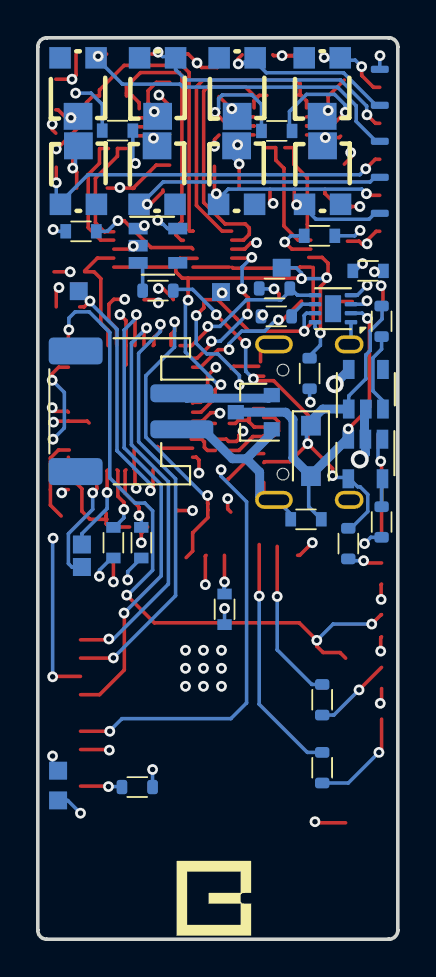
[picture p25: board fsr_controller.kicad_pcb from below]

Board: 4 copper layers, 20.0 x 50.1 mm, 84 parts (41 on the bottom side), 68 nets.
