seanboe/fsr_controller/(commit log)

2024-06-20 streamign to computer working
    [fsr_controller.step, fsr_controller2.kicad_pcb]
2025-02-23 updated library
    [fsr_controller.step]
